Supermagnum/upyourfuzz/pedal.jpg

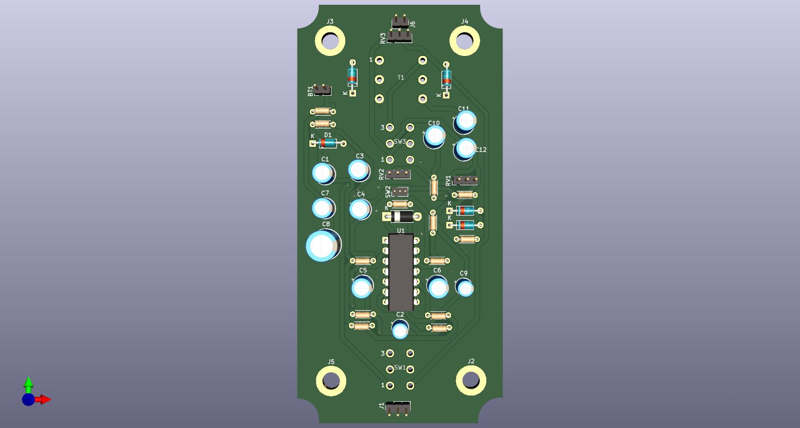
pedal.jpg
