Supermagnum/upyourfuzz/README.md

# This is a fuzz pedal using 4x opamps,it also has octave fuzz.
It needs 9 volt DC battery.
