Supermagnum/upyourfuzz/partslist.xlsx

Index | Manufacturer Part Number | Manufacturer Name | Description | Attrition % | Requested Quantity 1 | Pack Quantity 1 | Pack Type 1 | Digi-Key Part Number 1 | Unit Price 1 | Extended Price 1 | Minimum Order Quantity 1 | Requested Part Number | US Import Tariff | Original Part numbers
1 | MF0207FRE52-470R | YAGEO | RES 470 OHM 1% 0.6W AXIAL |  | 1 | 1 | Cut Tape (CT) | 13-MF0207FRE52-470RCT-ND | 1.06000 | kr1.06 | 1 | 13-MF0207FRE52-470RCT-ND | May apply on shipments to the U.S. | 13-MF0207FRE52-470RCT-ND
2 | 1N4007-T | Diodes Incorporated | DIODE GEN PURP 1KV 1A DO41 |  | 1 | 1 | Cut Tape (CT) | 1N4007DICT-ND | 2.12000 | kr2.12 | 1 | 1N4007DICT-ND | May apply on shipments to the U.S. | 1N4007DICT-ND
3 | 11 | Switchcraft Inc. | CONN JACK MONO 6.35MM PNL MNT |  | 2 | 2 | Bulk | SC1085-ND | 42.21000 | kr84.42 | 1 | SC1085-ND | N/A | SC1085-ND
4 | SFR16S0001004JA500 | Vishay Beyschlag/Draloric/BC Components | RES 1M OHM 1/2W 5% AXIAL |  | 2 | 2 | Cut Tape (CT) | BC4297CT-ND | 2.12000 | kr4.24 | 1 | BC4297CT-ND | N/A | BC4297CT-ND
5 | P170N-QC12BR500K | TT Electronics/BI | POT 500K OHM 1/10W PLASTIC LIN |  | 1 | 1 | Tray | 987-1315-ND | 17.67000 | kr17.67 | 1 | 987-1315-ND | May apply on shipments to the U.S. | 987-1315-ND
6 | P230-2EC22BR20K | TT Electronics/BI | POT 20K OHM 1/2W PLASTIC LINEAR |  | 1 | 1 | Tray | 987-1660-ND | 52.58000 | kr52.58 | 1 | 987-1660-ND | May apply on shipments to the U.S. | 987-1660-ND
7 | P160KNP-0EC15B100K | TT Electronics/BI | POT 100K OHM 1/5W PLASTIC LINEAR |  | 1 | 1 | Tray | 987-1723-ND | 16.40000 | kr16.40 | 1 | 987-1723-ND | May apply on shipments to the U.S. | 987-1723-ND
8 | FS5700DPLT2B2M2QE | E-Switch | SWITCH PUSHBUTTON DPDT 1A 9V |  | 2 | 2 | Bulk | EG5498-ND | 74.59000 | kr149.18 | 1 | EG5498-ND | May apply on shipments to the U.S. | EG5498-ND
9 | 142B | Hammond Manufacturing | AUDIO TRANSFORMER, OPEN FRAME PC |  | 1 | 1 | Bulk | 164-142B-ND | 70.99000 | kr70.99 | 1 | 164-142B-ND | N/A | 164-142B-ND
10 | BAT85S-TAP | Vishay General Semiconductor - Diodes Division | DIODE SCHOTTKY 30V 200MA DO35 |  | 2 | 2 | Cut Tape (CT) | BAT85S-TAPCT-ND | 3.91000 | kr7.82 | 1 | BAT85S-TAPCT-ND | May apply on shipments to the U.S. | BAT85S-TAPCT-ND
11 | 1N5819 | STMicroelectronics | SCHOTTKY DO15 40V 1A 150C |  | 2 | 2 | Cut Tape (CT) | 497-6610-1-ND | 4.02000 | kr8.04 | 1 | 497-6610-1-ND | May apply on shipments to the U.S. | 497-6610-1-ND
12 | SFR16S0001002JA500 | Vishay Beyschlag/Draloric/BC Components | RES 10K OHM 1/2W 5% AXIAL |  | 3 | 3 | Cut Tape (CT) | BC4294CT-ND | 2.12000 | kr6.36 | 1 | BC4294CT-ND | N/A | BC4294CT-ND
13 | SFR16S0001001JA500 | Vishay Beyschlag/Draloric/BC Components | RES 1K OHM 1/2W 5% AXIAL |  | 1 | 1 | Cut Tape (CT) | BC4292CT-ND | 2.12000 | kr2.12 | 1 | BC4292CT-ND | N/A | BC4292CT-ND
14 | SFR16S0004701JA500 | Vishay Beyschlag/Draloric/BC Components | RES 4.7K OHM 1/2W 5% AXIAL |  | 1 | 1 | Cut Tape (CT) | BC4328CT-ND | 2.12000 | kr2.12 | 1 | BC4328CT-ND | N/A | BC4328CT-ND
15 | K473K10X7RF5UH5 | Vishay Beyschlag/Draloric/BC Components | CAP CER 0.047UF 50V X7R RADIAL |  | 1 | 1 | Cut Tape (CT) | BC2686CT-ND | 2.65000 | kr2.65 | 1 | BC2686CT-ND | May apply on shipments to the U.S. | BC2686CT-ND
16 | K104K15X7RF5TH5 | Vishay Beyschlag/Draloric/BC Components | CAP CER 0.1UF 50V X7R RADIAL |  | 1 | 1 | Cut Tape (CT) | BC1101CT-ND | 2.54000 | kr2.54 | 1 | BC1101CT-ND | May apply on shipments to the U.S. | BC1101CT-ND
17 | ECA-1VM100I | Panasonic Electronic Components | CAP ALUM 10UF 20% 35V RADIAL |  | 3 | 3 | Cut Tape (CT) | P19549CT-ND | 2.22000 | kr6.66 | 1 | P19549CT-ND | N/A | P19549CT-ND
18 | ESS105M050AB2EA | KEMET | CAP ALUM 1UF 20% 50V RADIAL |  | 1 | 1 | Cut Tape (CT) | 399-ESS105M050AB2EACT-ND | 2.22000 | kr2.22 | 1 | 399-ESS105M050AB2EACT-ND | May apply on shipments to the U.S. | 399-ESS105M050AB2EACT-ND
19 | K104K15X7RF53H5G | Vishay Beyschlag/Draloric/BC Components | K 50V 100NF 10% X7R BULK GREEN A |  | 2 | 2 | Bulk | 56-K104K15X7RF53H5G-ND | 6.56000 | kr13.12 | 1 | 56-K104K15X7RF53H5G-ND | May apply on shipments to the U.S. | 56-K104K15X7RF53H5G-ND
20 | UVR1HR22MDD | Nichicon | CAP ALUM 0.22UF 20% 50V RADIAL |  | 1 | 1 | Bulk | 493-1096-ND | 2.96000 | kr2.96 | 1 | 493-1096-ND | N/A | 493-1096-ND
21 | TL084CN | Texas Instruments | IC OPAMP JFET 4 CIRCUIT 14DIP |  | 1 | 1 | Tube | 296-1784-5-ND | 9.10000 | kr9.10 | 1 | 296-1784-5-ND | N/A | 296-1784-5-ND
22 | 100SP3T1B1M1QEH | E-Switch | SWITCH TOGGLE SPDT 5A 120V |  | 1 | 1 | Bulk | EG2375-ND | 35.23000 | kr35.23 | 1 | EG2375-ND | May apply on shipments to the U.S. | EG2375-ND
23 | PM5BWD | Bivar Inc. | LED ASSY PNL 5MM BLUE DIFF 430NM |  | 1 | 1 | Tray | 492-1542-ND | 25.92000 | kr25.92 | 1 | 492-1542-ND | N/A | 492-1542-ND
24 | SFR25H0002000FR500 | Vishay Beyschlag/Draloric/BC Components | RES 200 OHM 1/2W 1% AXIAL |  | 1 | 1 | Cut Tape (CT) | 56-SFR25H0002000FR500CT-ND | 2.65000 | kr2.65 | 1 | 56-SFR25H0002000FR500CT-ND | N/A | 56-SFR25H0002000FR500CT-ND
25 | MBA02040C3000FCT00 | Vishay Beyschlag/Draloric/BC Components | RES 300 OHM 0.4W 1% AXIAL |  | 1 | 1 | Cut Tape (CT) | BC3268CT-ND | 2.65000 | kr2.65 | 1 | BC3268CT-ND | N/A | BC3268CT-ND
26 | MFR-25FTE52-51K | YAGEO | RES 51K OHM 1% 1/4W AXIAL |  | 1 | 1 | Cut Tape (CT) | 13-MFR-25FTE52-51KCT-ND | 1.06000 | kr1.06 | 1 | 13-MFR-25FTE52-51KCT-ND | N/A | 13-MFR-25FTE52-51KCT-ND
27 | 1590B | Hammond Manufacturing | BOX ALUM UNPTD 4.409"L X 2.382"W |  | 1 | 1 | Bulk | HM151-ND | 106.22000 | kr106.22 | 1 | HM151-ND | N/A | HM151-ND
28 | 235 | Keystone Electronics | BATT CONN SNAP 9V 1 CEL 4" LEADS |  | 1 | 1 | Bulk | 36-235-ND | 5.92000 | kr5.92 | 1 | 36-235-ND | N/A | 36-235-ND
29 | A 14-LC-TT | Assmann WSW Components | CONN IC DIP SOCKET 14POS TIN |  | 1 | 1 | Tube | AE9989-ND | 2.96000 | kr2.96 | 1 | AE9989-ND | N/A | AE9989-ND
