Supermagnum/upyourfuzz/1590B/1590B.stp

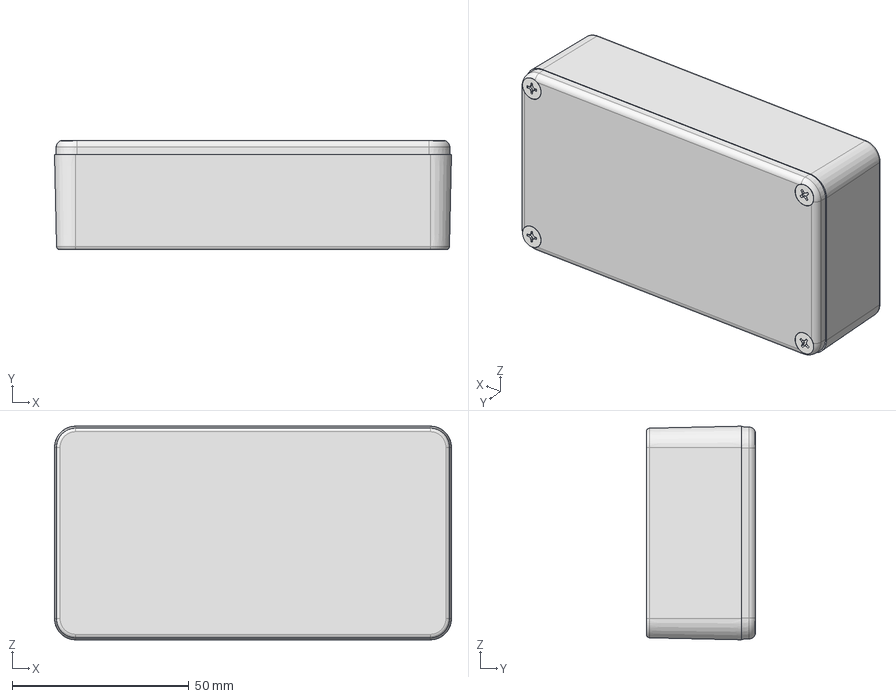
[picture p2: CAD file, 2024-01-19]
1590B/1590B.stp
112.4 x 31.0 x 60.5 mm
