Supermagnum/upyourfuzz/(list of files, cad)

Other CAD files:
1590B/1590B.FCStd
1590B/1590B.igs
