Supermagnum/upyourfuzz/pedal.pdf

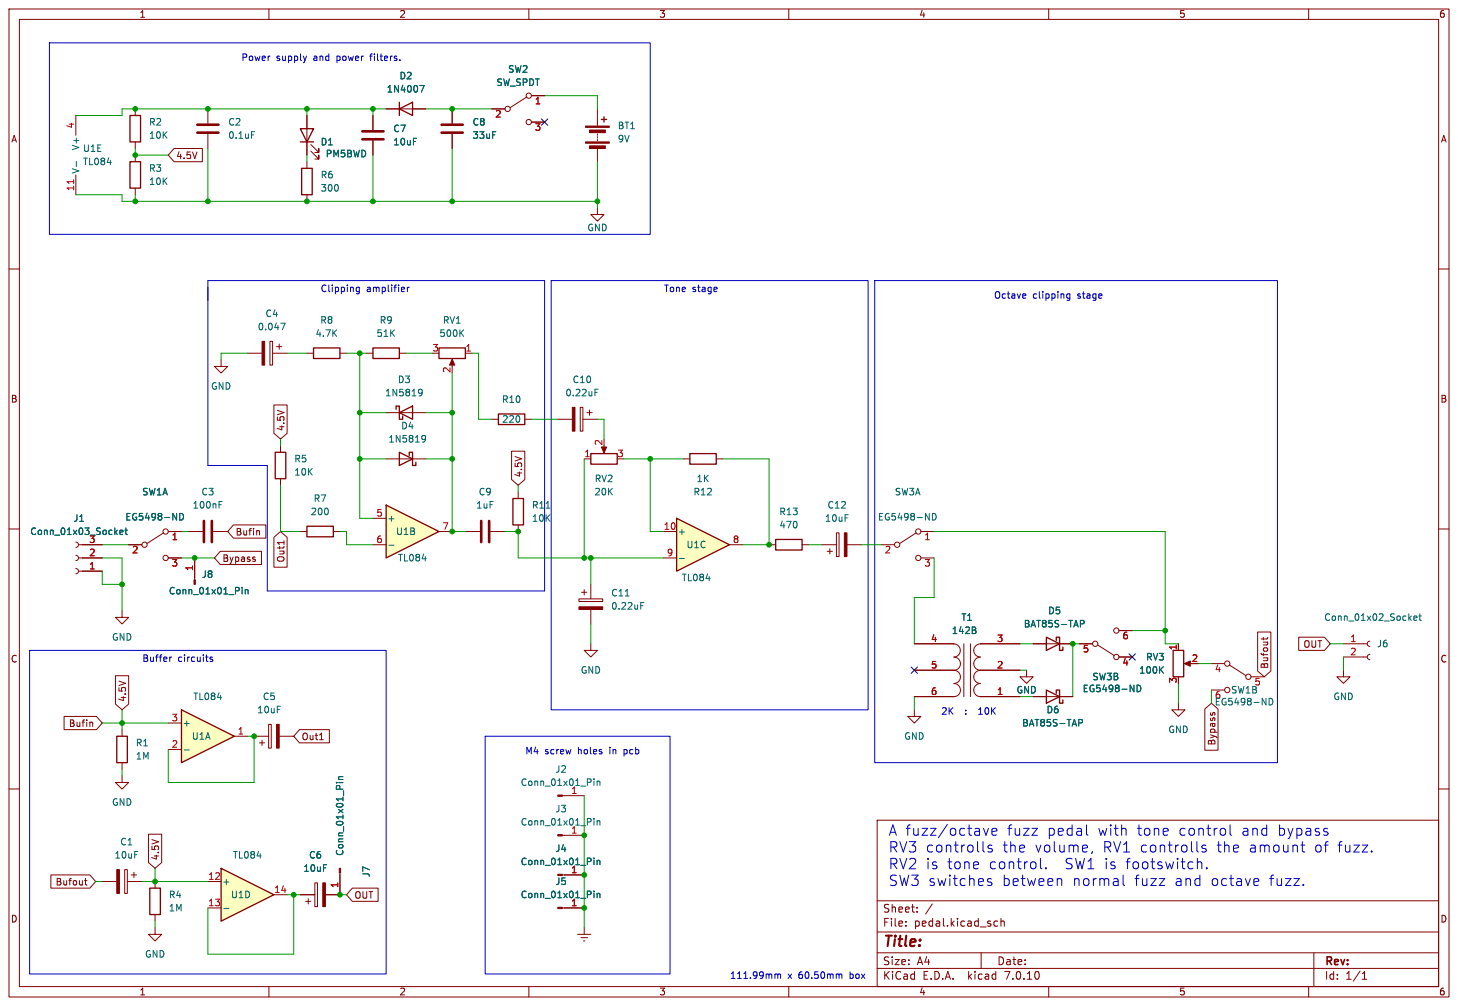
[picture p3: page 1]

Power supply and power filters.
D5 BAT85S-TAP R3
