Supermagnum/upyourfuzz/pedal.kicad_sch

## KiCad design pedal.kicad_sch (2024-02-08)

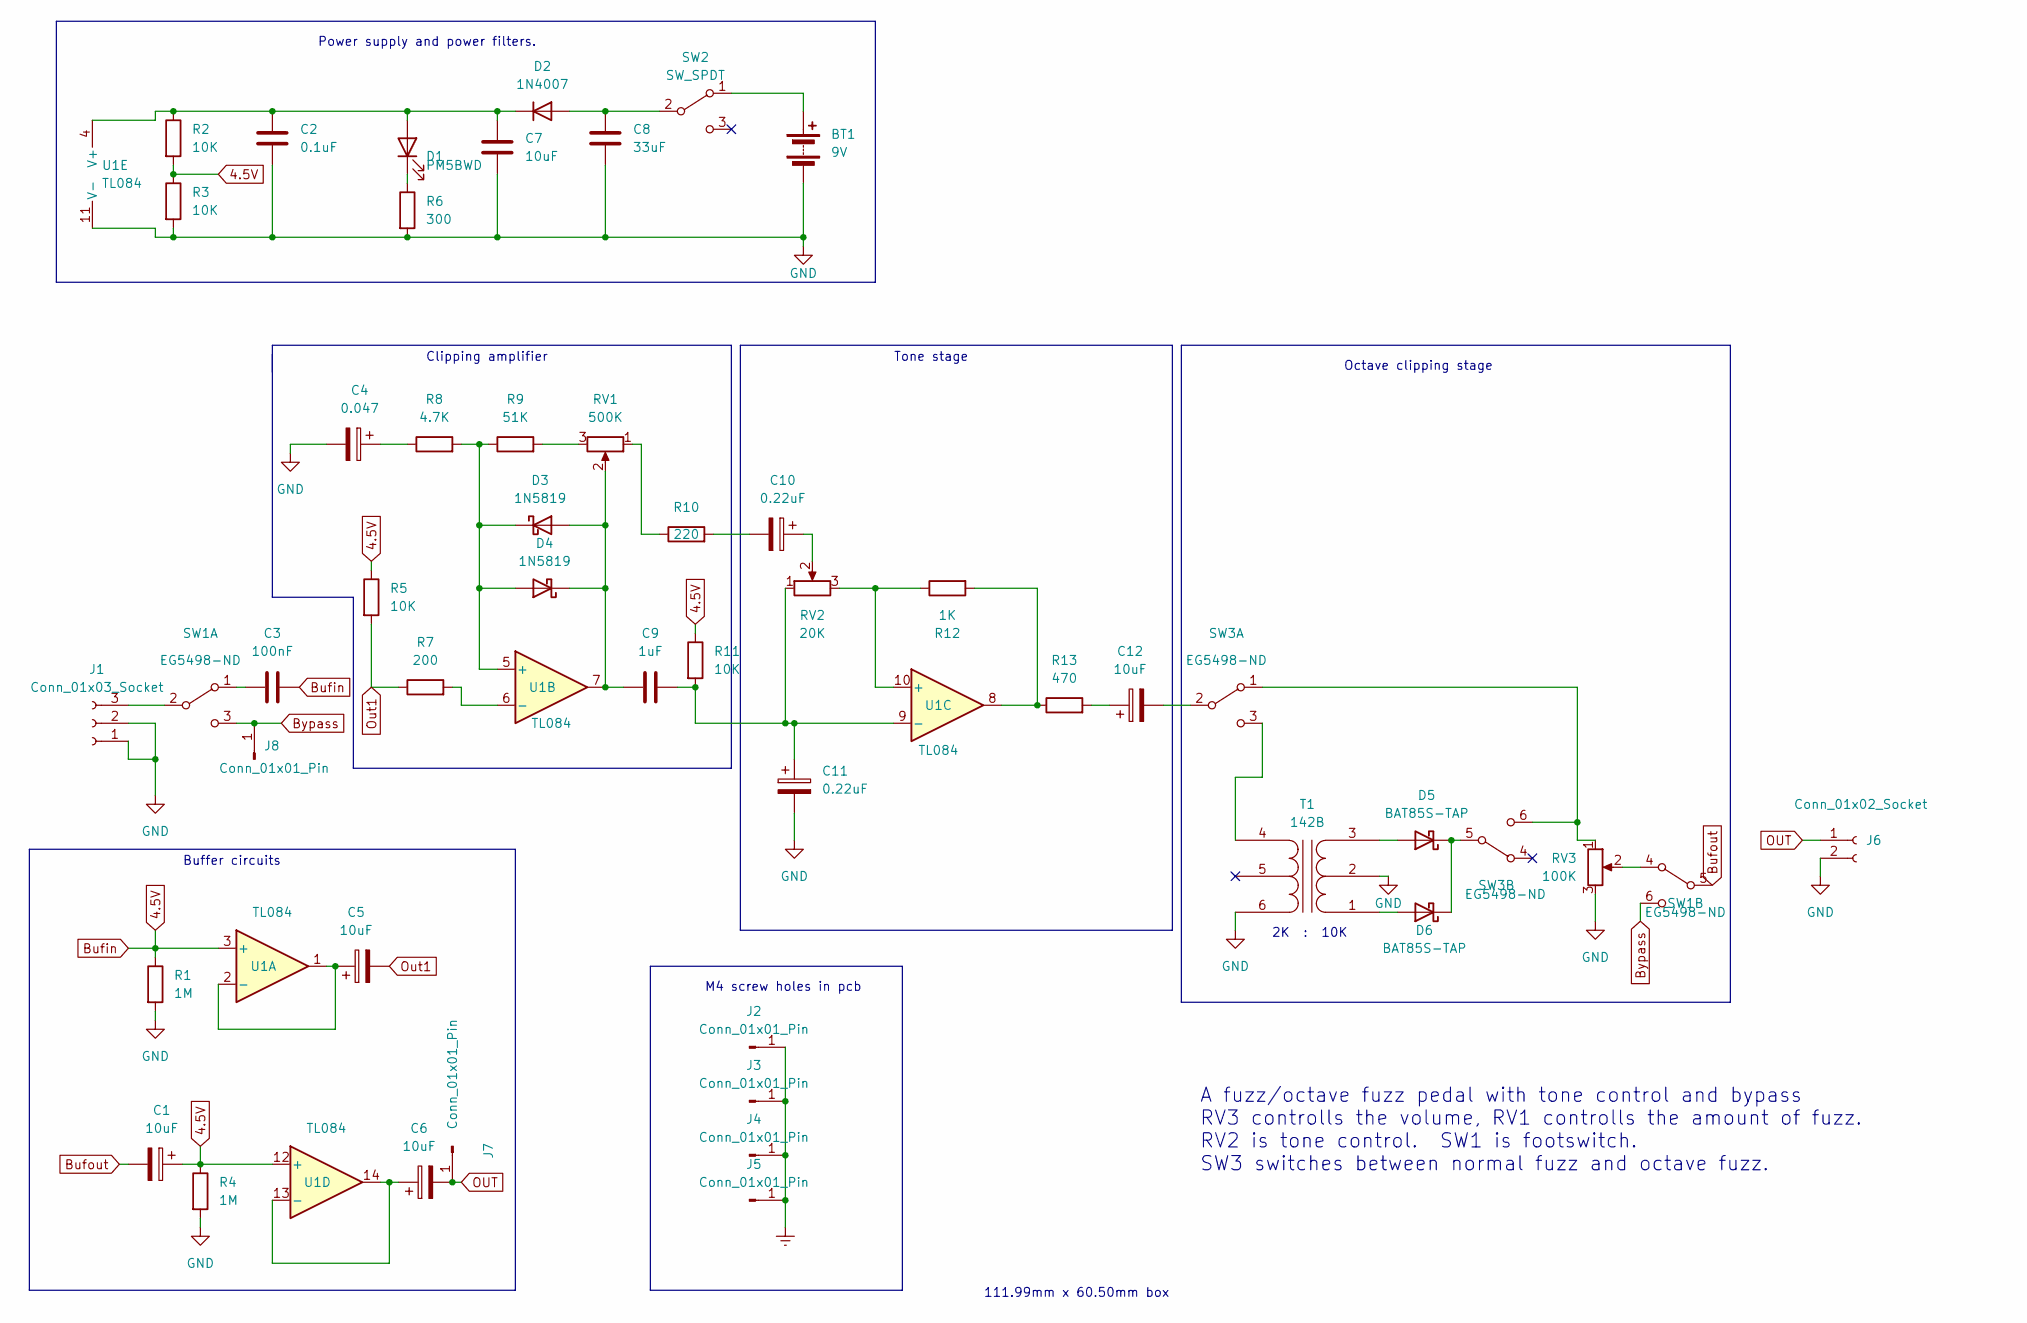
[picture p4: schematic pedal.kicad_sch]

Parts:
BT1: 9V; PinHeader_1x02_P2.00mm_Vertical
C1, C5, C6, C7, C12: 10uF; CP_Radial_D5.0mm_P2.50mm
C2: 0.1uF; CP_Radial_D4.0mm_P2.00mm
C3: 100nF; CP_Radial_D5.0mm_P2.50mm
C4: 0.047; CP_Radial_D5.0mm_P2.00mm
C8: 33uF; CP_Radial_D7.5mm_P2.50mm
C9: 1uF; CP_Radial_D4.0mm_P1.50mm
C10: 0.22uF; CP_Radial_D5.0mm_P2.00mm
C11: 0.22uF; CP_Radial_D5.0mm_P2.50mm
D1: PM5BWD; D_DO-35_SOD27_P7.62mm_Horizontal
D2: 1N4007; D_DO-41_SOD81_P7.62mm_Horizontal
D3, D4: 1N5819; D_DO-35_SOD27_P7.62mm_Horizontal
D5, D6: BAT85S-TAP; D_DO-35_SOD27_P7.62mm_Horizontal
J1: Conn_01x03_Socket; PinHeader_1x03_P2.00mm_Vertical
J2, J3, J4, J5: Conn_01x01_Pin; MountingHole_4.3mm_M4_DIN965_Pad
J6: Conn_01x02_Socket; PinHeader_1x02_P2.00mm_Vertical
J7, J8: Conn_01x01_Pin; PinHeader_1x01_P2.00mm_Vertical
R1, R4: 1M; R_Axial_DIN0204_L3.6mm_D1.6mm_P5.08mm_Horizontal
R2, R3, R5, R11: 10K; R_Axial_DIN0204_L3.6mm_D1.6mm_P5.08mm_Horizontal
R6: 300; R_Axial_DIN0204_L3.6mm_D1.6mm_P5.08mm_Horizontal
R7: 200; R_Axial_DIN0204_L3.6mm_D1.6mm_P5.08mm_Horizontal
R8: 4.7K; R_Axial_DIN0204_L3.6mm_D1.6mm_P5.08mm_Horizontal
R9: 51K; R_Axial_DIN0204_L3.6mm_D1.6mm_P5.08mm_Horizontal
R10: 220; R_Axial_DIN0204_L3.6mm_D1.6mm_P5.08mm_Horizontal
R12: 1K; R_Axial_DIN0204_L3.6mm_D1.6mm_P5.08mm_Horizontal
R13: 470; R_Axial_DIN0204_L3.6mm_D1.6mm_P5.08mm_Horizontal
RV1: 500K; PinHeader_1x03_P2.00mm_Vertical
RV2: 20K; PinHeader_1x03_P2.00mm_Vertical
RV3: 100K; PinHeader_1x03_P2.00mm_Vertical
SW1, SW3: EG5498-ND
SW2: SW_SPDT; PinHeader_1x03_P1.27mm_Vertical
T1: 142B
U1: TL084; DIP-14_W7.62mm

Connections:
4.5V: C1.1, C3.2, R1.1, R2.2, R3.1, R4.1, R5.1, R11.1, U1.3 (+), U1.12 (+)
Bufout: C1.2, SW1.5 (B)
Bypass: J8.1, SW1.3 (C), SW1.6 (C)
Earth: J2.1, J3.1, J4.1, J5.1
GND: BT1.2 (-), C2.2, C4.2, C7.2, C8.2, C11.2, J1.1, J1.2, J6.2, R1.2, R3.2, R4.2, R6.2, RV3.3, T1.2 (PM), T1.6 (S2), U1.11 (V-)
unnamed: BT1.1 (+), SW2.1 (A)
unnamed: C2.1, C7.1, D1.2 (A), D2.1 (K), R2.1, U1.4 (V+)
unnamed: C3.1, SW1.1 (A)
unnamed: C4.1, R8.1
unnamed: C5.1, U1.1, U1.2 (-)
unnamed: C6.1, U1.13 (-), U1.14
unnamed: C8.1, D2.2 (A), SW2.2 (B)
unnamed: C9.1, D3.2 (A), D4.1 (K), RV1.2, U1.7
unnamed: C10.1, RV2.2
unnamed: C10.2, R10.2
unnamed: C9.2, C11.1, R11.2, RV2.1, U1.9 (-)
unnamed: C12.1, R13.2
unnamed: C12.2, SW3.2 (B)
unnamed: D1.1 (K), R6.1
unnamed: D3.1 (K), D4.2 (A), R8.2, R9.1, U1.5 (+)
unnamed: D5.1 (K), D6.1 (K), SW3.5 (B)
unnamed: D5.2 (A), T1.3 (PR2)
unnamed: D6.2 (A), T1.1 (PR1)
unnamed: J1.3, SW1.2 (B)
unnamed: R7.2, U1.6 (-)
unnamed: R9.2, RV1.3
unnamed: R10.1, RV1.1
unnamed: R12.1, RV2.3, U1.10 (+)
unnamed: R12.2, R13.1, U1.8
unnamed: RV3.1, SW3.1 (A), SW3.6 (C)
unnamed: RV3.2, SW1.4 (A)
unnamed: SW3.3 (C), T1.4 (S1)
OUT: C6.2, J6.1, J7.1
Out1: C5.2, R5.2, R7.1

Notes on the sheet:
111.99mm x 60.50mm box
Octave clipping stage
A fuzz/octave fuzz pedal with tone control and bypass RV3 controlls the volume, RV1 controlls the amount of fuzz. RV2 is tone control. SW1 is footswitch. SW3 switches between normal fuzz and octave fuzz.
2K : 10K
Tone stage
Power supply and power filters.
Clipping amplifier
M4 screw holes in pcb
Buffer circuits
